kcriqui/2025-Communicator_Badge/README.md

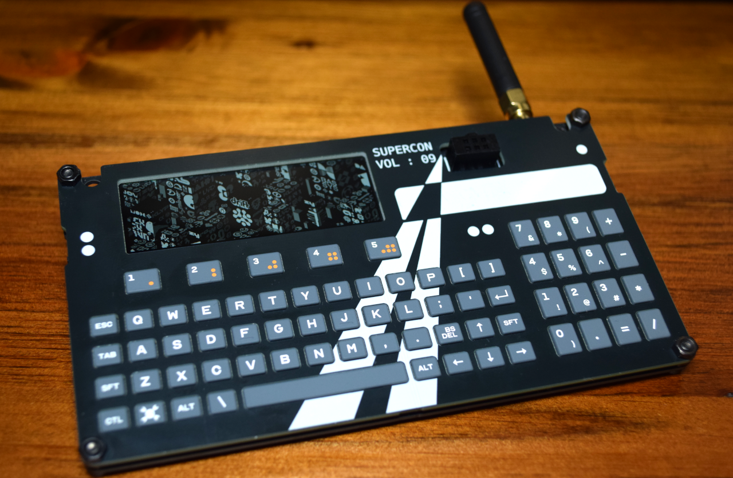
[picture p1: images/2025_badge_front_supercon_logo.png]
The_Badge 2025 Hackaday Supercon Communicator Badge
