kcriqui/2025-Communicator_Badge/documentation/datasheets/spi_screen_connector.png

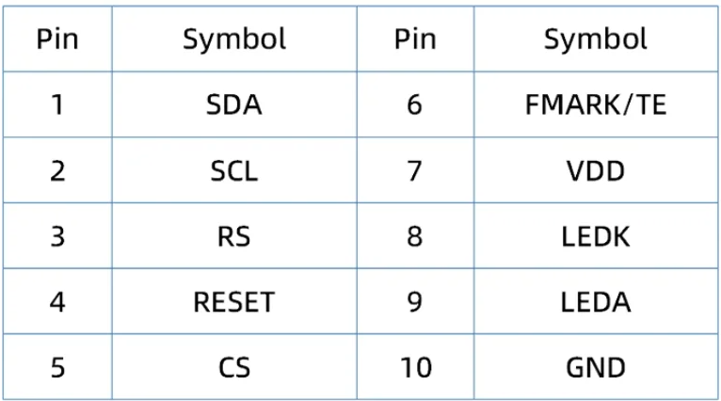
documentation/datasheets/spi_screen_connector.png
