kcriqui/2025-Communicator_Badge/documentation/datasheets/spi_screen_physical.png

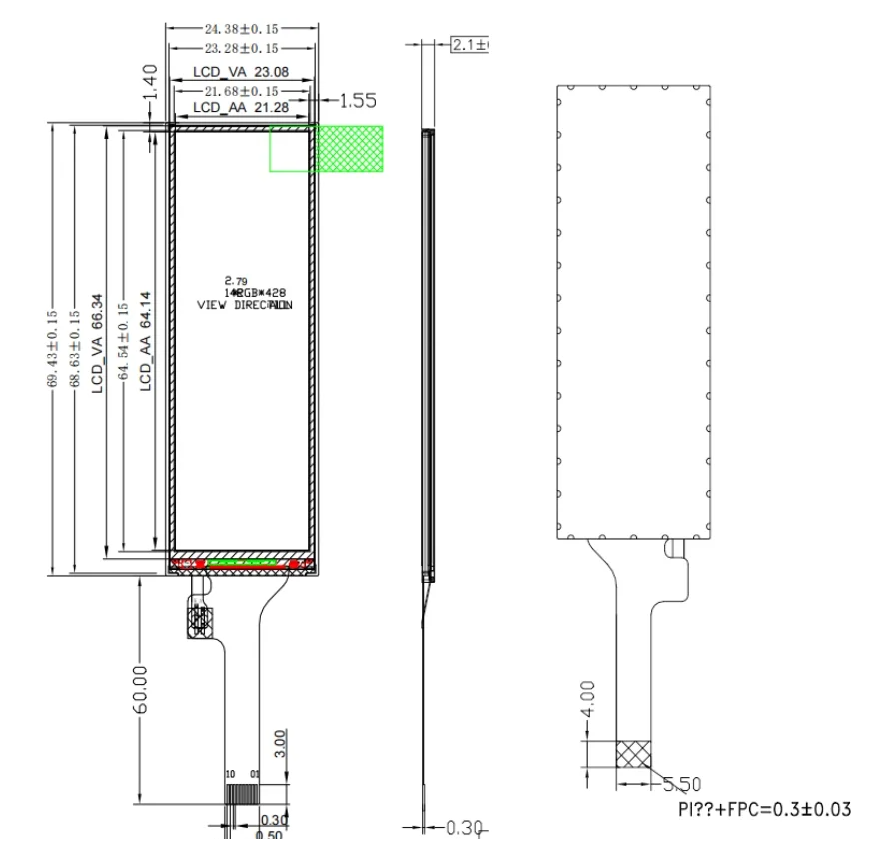
documentation/datasheets/spi_screen_physical.png
