kcriqui/2025-Communicator_Badge/hardware/communicator_proto_3d.png

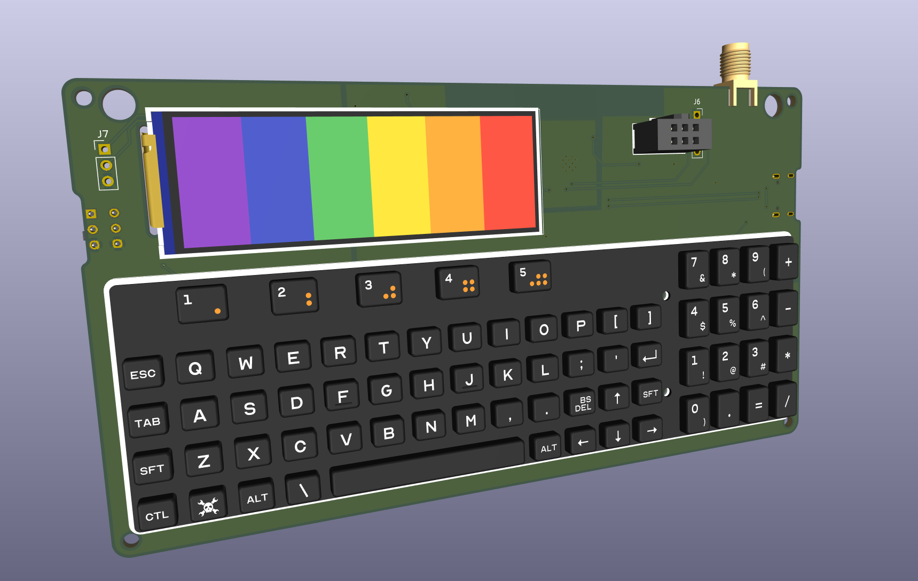
hardware/communicator_proto_3d.png
