kcriqui/2025-Communicator_Badge/hardware/communicator_proto_back_3d.png

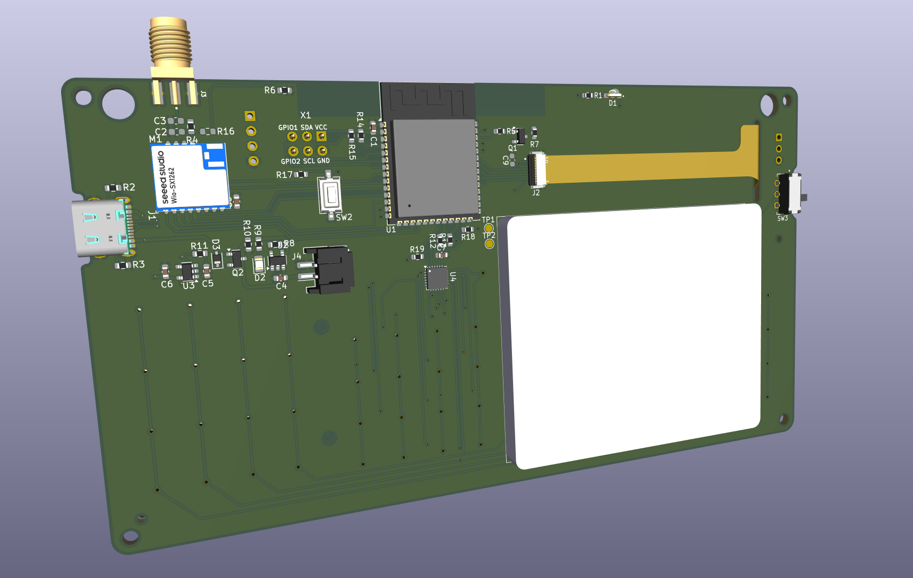
hardware/communicator_proto_back_3d.png
