kcriqui/2025-Communicator_Badge/images/2025_supercon_header.png

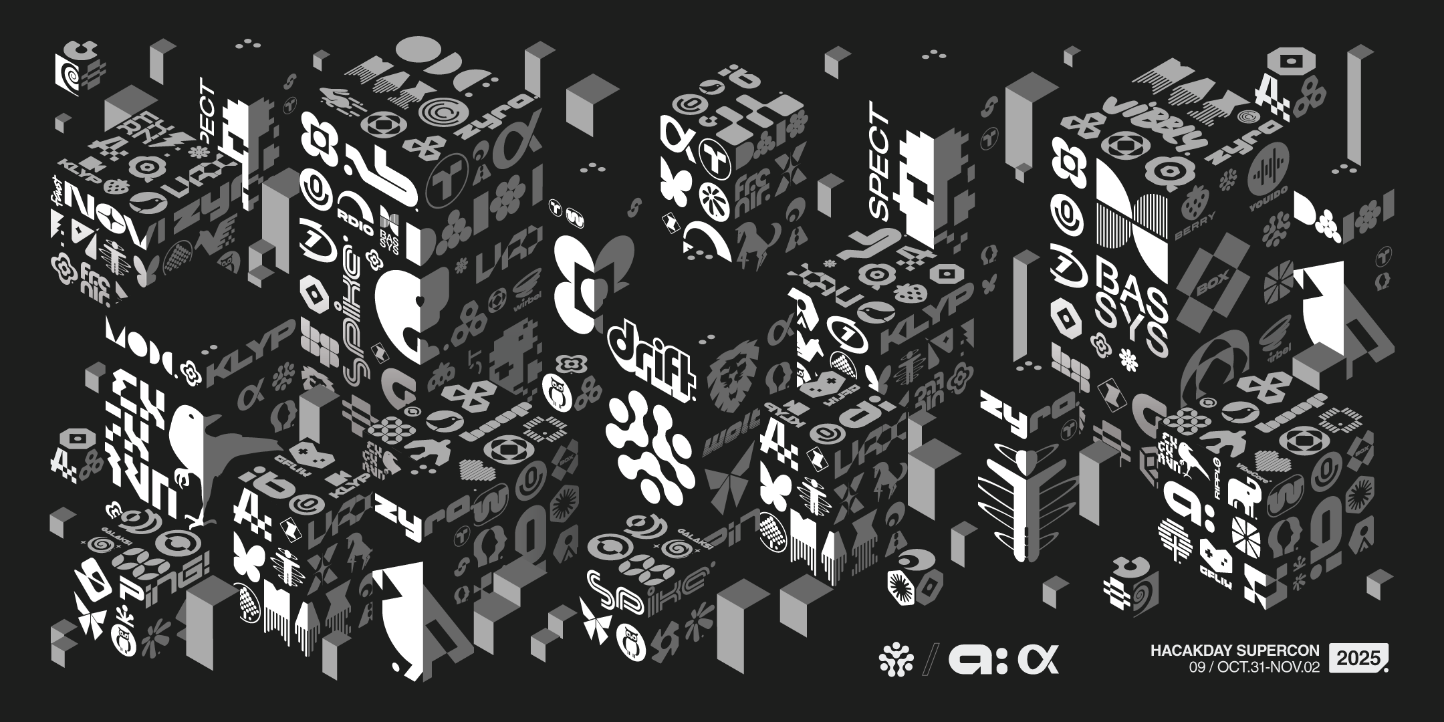
images/2025_supercon_header.png
