kcriqui/2025-Communicator_Badge/hardware/mechanicals_and_models/communicator_badge_main_pcb.FCStd

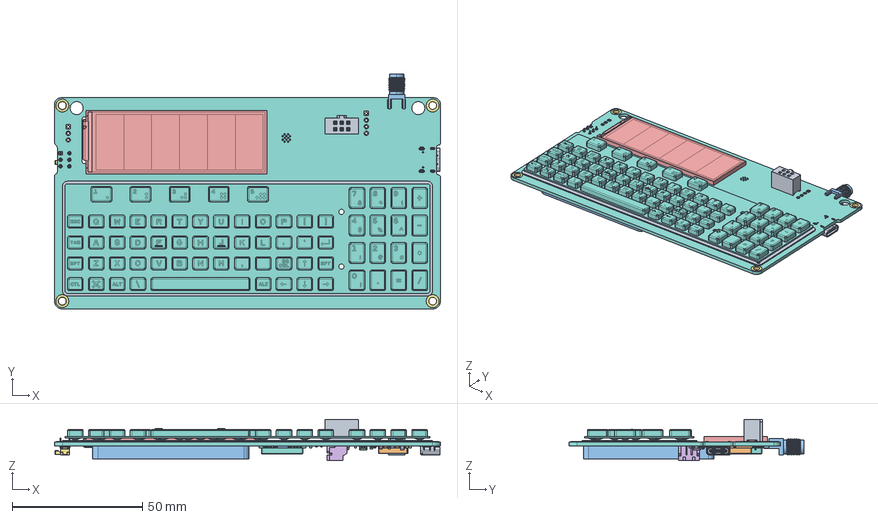
[picture p7: CAD file, 2025-10-24]
hardware/mechanicals_and_models/communicator_badge_main_pcb.FCStd
148.0 x 90.1 x 15.8 mm
SFH11-xC-Dx-ST-BK body_03
pin^SFH11-xC-Dx-ST-BK Ass
pin^SFH11-xC-Dx-ST-BK Ass001
pin^SFH11-xC-Dx-ST-BK Ass002
pin^SFH11-xC-Dx-ST-BK Ass003
pin^SFH11-xC-Dx-ST-BK Ass004
pin^SFH11-xC-Dx-ST-BK Ass005
Keyboard
Dome_Sheet
R_0603_1608Metric
LED_0805_2012Metric
R_0603_1608Metric001
R_0603_1608Metric002
R_0603_1608Metric003
SLW-91353-2A-RA-D
D_SOD-323
12402012E212A
R_0603_1608Metric004
R_0603_1608Metric005
SOT-23-5
R_0603_1608Metric006
C_0603_1608Metric
R_0603_1608Metric007
ESP32-S3-WROOM-1
C_0603_1608Metric001
Wio-SX1262_ v1
C_0603_1608Metric002
R_0603_1608Metric008
glass housing
PCB
contact-pins
R_0603_1608Metric009
C_0603_1608Metric003
C_0603_1608Metric004
TCA8418RTWR
SW_Tactile_SPST_NO_Straight_CK_PTS636Sx25SMTRLFS
SOT-23
SOT-23-006
R_0603_1608Metric010
R_0603_1608Metric011
R_0603_1608Metric012
R_0603_1608Metric013
CON-SMA-EDGE-S_CON-SMA-EDGE-S
c-1-2328702-0-a-3d
ER-TFT2.79-1
R_0603_1608Metric014
R_0603_1608Metric015
R_0603_1608Metric016
SOT-024
C_0603_1608Metric005
LiPo-Body
R_0603_1608Metric017
R_0603_1608Metric018
S2B-PH-SM4-TB
communicator_pcb_pad
communicator_pcb_PCB
