kcriqui/2025-Communicator_Badge/hardware/communicator_front/communicator_pcb-front_boardBody.dxf

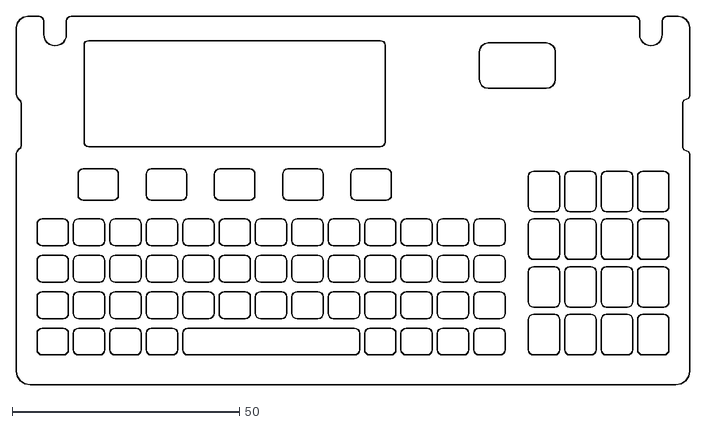
[picture p8: CAD file, 2025-10-23]
hardware/communicator_front/communicator_pcb-front_boardBody.dxf
148.0 x 81.0
