kcriqui/2025-Communicator_Badge/hardware/communicator_pcb.FCStd

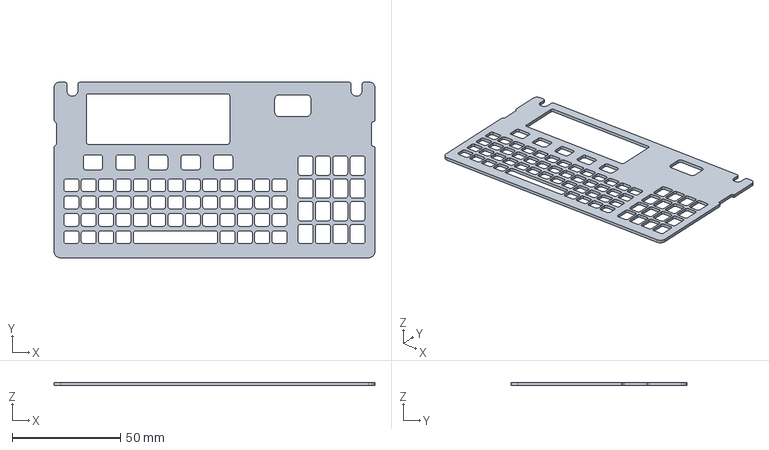
[picture p9: CAD file, 2025-10-23]
hardware/communicator_pcb.FCStd
148.0 x 81.0 x 1.60 mm
