kcriqui/2025-Communicator_Badge/hardware/communicator_pcb/CON_SMA_EDGE_S/CON-SMA-EDGE-S.step

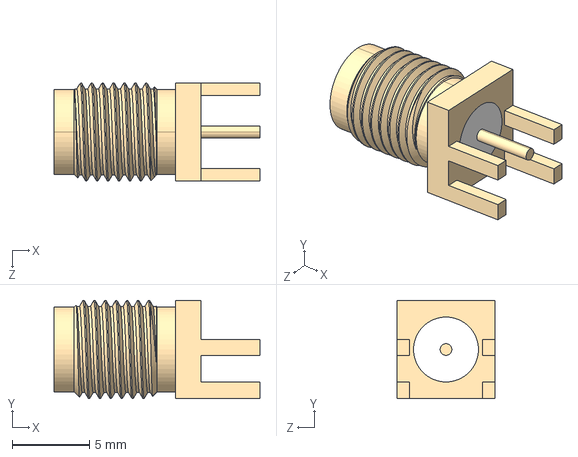
[picture p10: CAD file, 2025-10-23]
hardware/communicator_pcb/CON_SMA_EDGE_S/CON-SMA-EDGE-S.step
13.3 x 6.35 x 6.35 mm
