kcriqui/2025-Communicator_Badge/hardware/communicator_pcb/SAOv2/SFH11-PBPC-D03-ST-BK.STEP

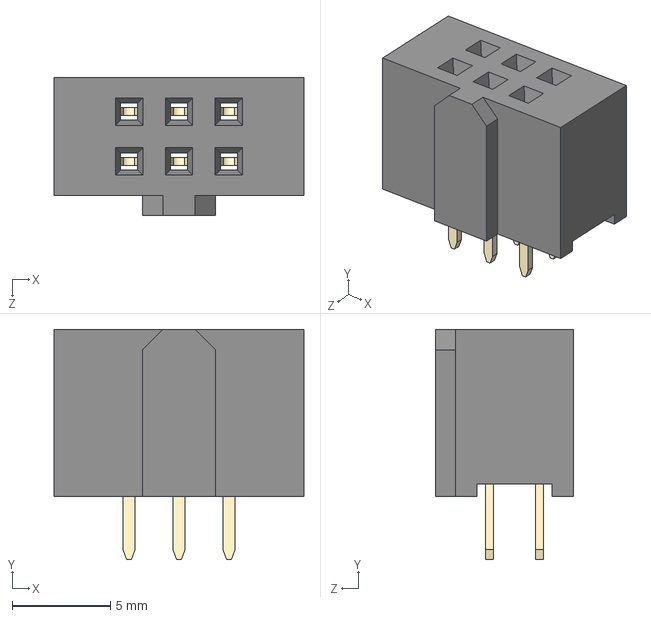
[picture p11: CAD file, 2025-10-23]
hardware/communicator_pcb/SAOv2/SFH11-PBPC-D03-ST-BK.STEP
12.7 x 11.7 x 7.01 mm
SFH11-xC-Dx-ST-BK body_03
pin^SFH11-xC-Dx-ST-BK Ass x 6
