kcriqui/2025-Communicator_Badge/hardware/communicator_pcb/SLW_1353_2A_RA_D/SLW-91353-2A-RA-D.step

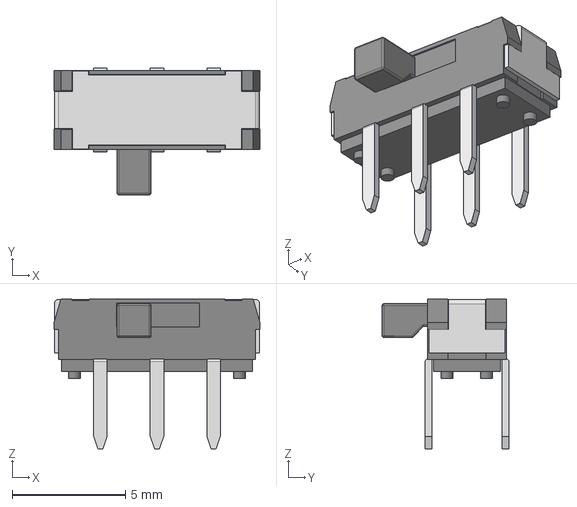
[picture p12: CAD file, 2025-10-23]
hardware/communicator_pcb/SLW_1353_2A_RA_D/SLW-91353-2A-RA-D.step
9.10 x 5.60 x 6.61 mm
