kcriqui/2025-Communicator_Badge/hardware/communicator_pcb/SMDNut/SMDNut_M2.0_H2.0mm.step

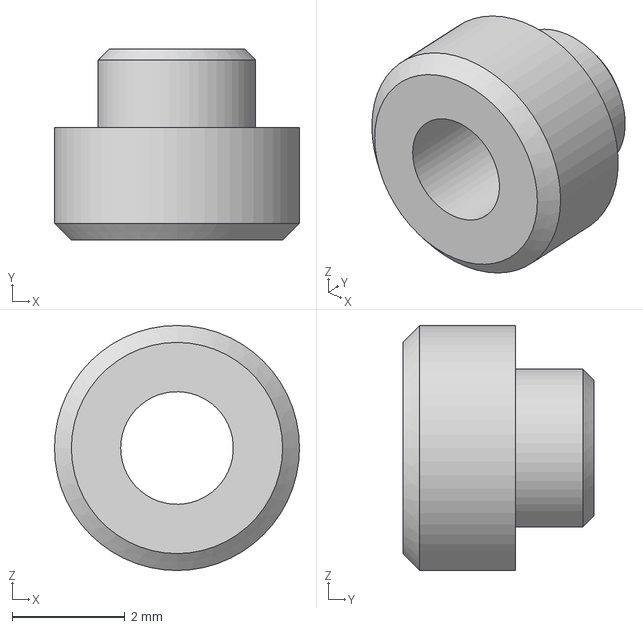
[picture p13: CAD file, 2025-10-23]
hardware/communicator_pcb/SMDNut/SMDNut_M2.0_H2.0mm.step
4.35 x 3.40 x 4.35 mm
