kcriqui/2025-Communicator_Badge/hardware/communicator_pcb/tca8418/QFN50P400X400X80-25N.step

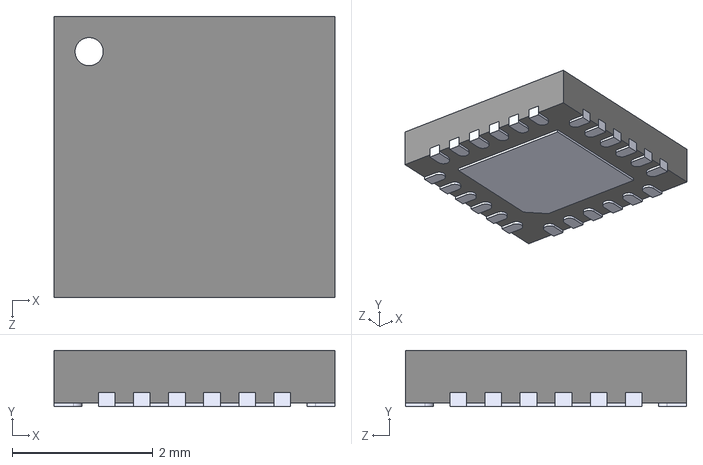
[picture p14: CAD file, 2025-10-23]
hardware/communicator_pcb/tca8418/QFN50P400X400X80-25N.step
4.00 x 0.8 x 4.00 mm
