kcriqui/2025-Communicator_Badge/hardware/communicator_pcb/TE_1-2328702-0/c-1-2328702-0-a-3d.step

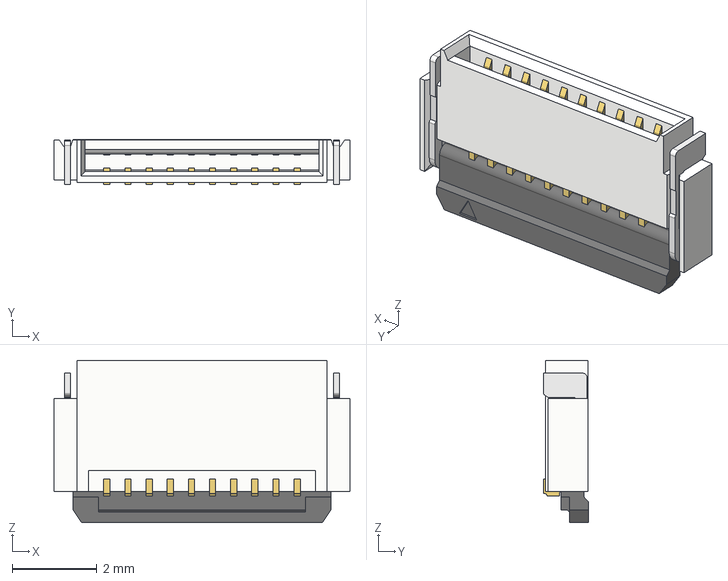
[picture p15: CAD file, 2025-10-23]
hardware/communicator_pcb/TE_1-2328702-0/c-1-2328702-0-a-3d.step
7.00 x 1.06 x 3.83 mm
