kcriqui/2025-Communicator_Badge/hardware/communicator_pcb/Wio1262/Wio-SX1262.step

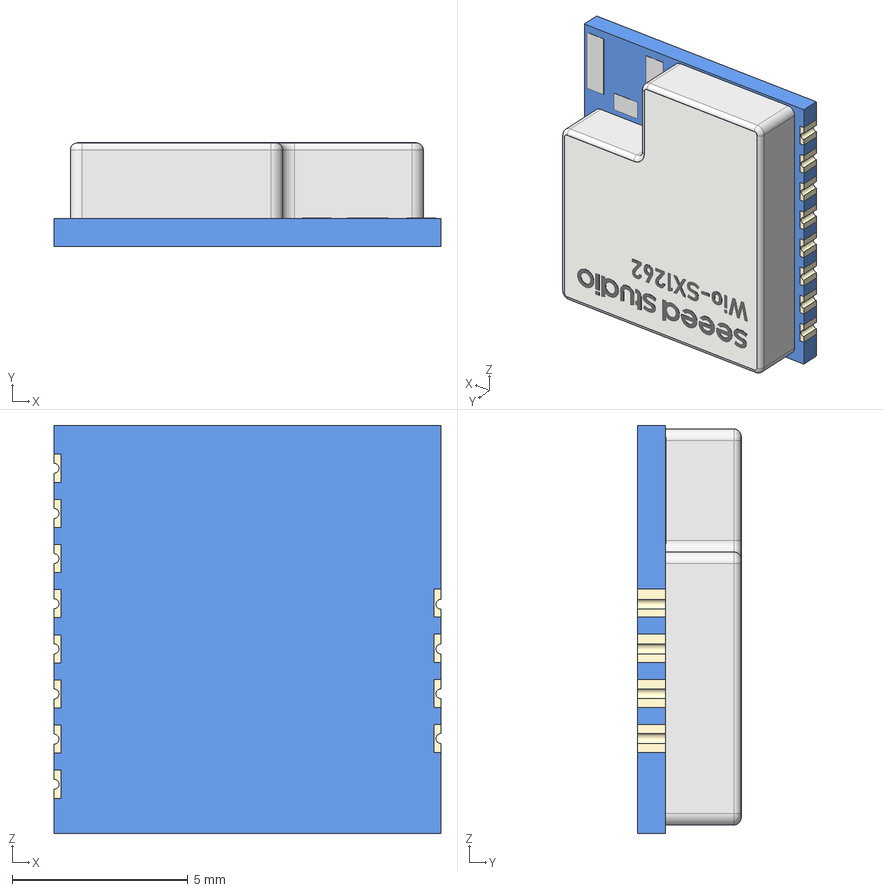
[picture p16: CAD file, 2025-10-23]
hardware/communicator_pcb/Wio1262/Wio-SX1262.step
11.0 x 2.97 x 11.6 mm
