kcriqui/2025-Communicator_Badge/hardware/communicator_pcb/wurth_led_155124YS73200/Common-Parts-Library.step

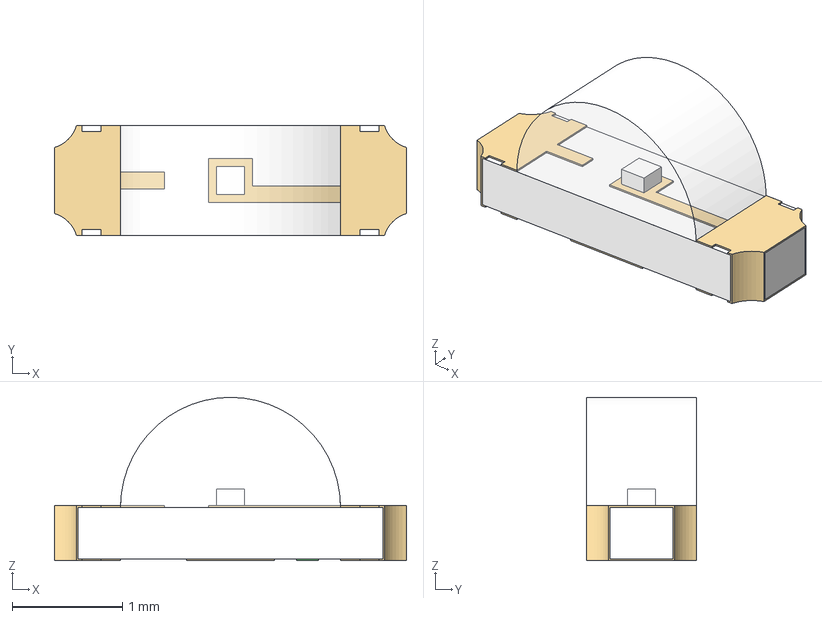
[picture p17: CAD file, 2025-10-23]
hardware/communicator_pcb/wurth_led_155124YS73200/Common-Parts-Library.step
3.20 x 1.00 x 1.48 mm
glass housing
PCB
contact-pins
