kcriqui/2025-Communicator_Badge/hardware/mechanicals_and_models/communicator_badge_front_pcb.step

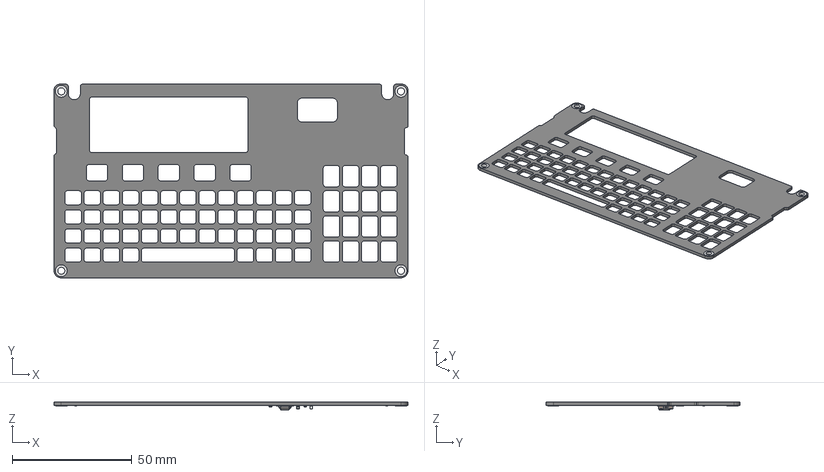
[picture p18: CAD file, 2025-10-24]
hardware/mechanicals_and_models/communicator_badge_front_pcb.step
148.0 x 81.0 x 3.39 mm
C_0805_2012Metric x 2
LED_0805_2012Metric
R_0805_2012Metric x 2
SOIC-8_3.9x4.9mm_P1.27mm
front_pcb_pad
front_pcb_PCB
