kcriqui/2025-Communicator_Badge/hardware/mechanicals_and_models/communicator_mechanical_components.step

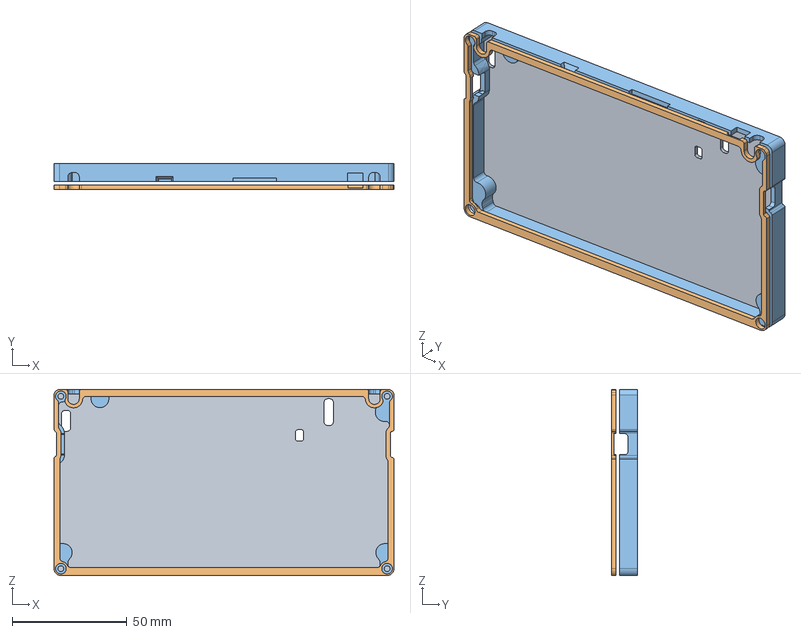
[picture p19: CAD file, 2025-10-24]
hardware/mechanicals_and_models/communicator_mechanical_components.step
148.0 x 11.5 x 81.0 mm
Back_cover
Front_Frame
Back_frame
