kcriqui/2025-Communicator_Badge/hardware/communicator_pcb/amphenol_12402012E212A/12402012E212A.step

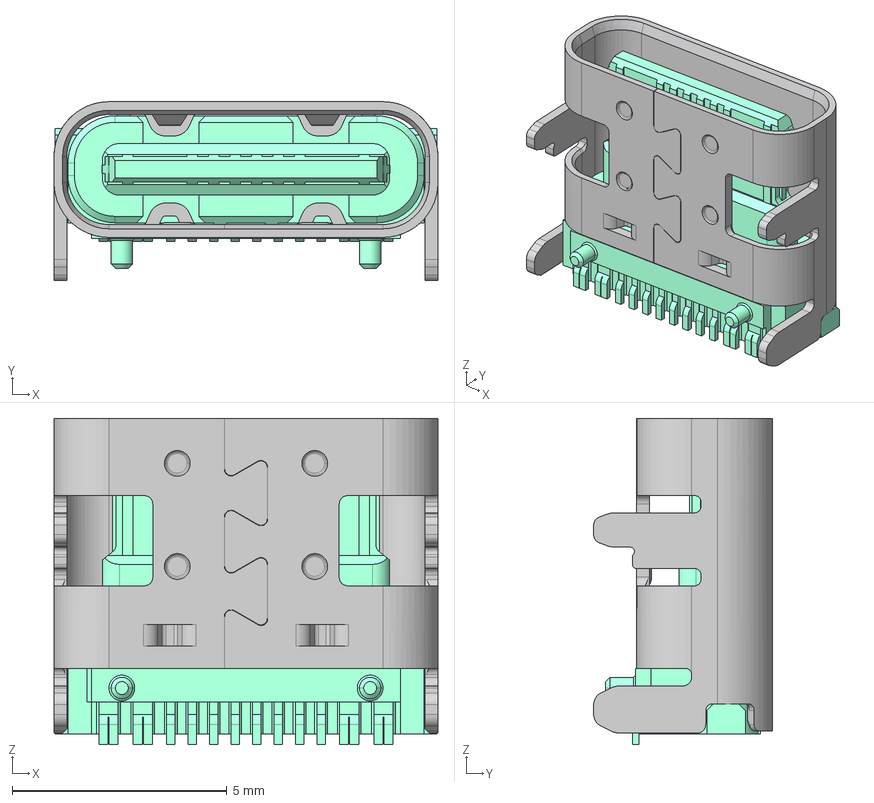
[picture p20: CAD file, 2025-10-23]
hardware/communicator_pcb/amphenol_12402012E212A/12402012E212A.step
8.94 x 4.16 x 7.60 mm
