kcriqui/2025-Communicator_Badge/(list of files, cad)

Other CAD files:
hardware/mechanicals_and_models/communicator_badge_front_pcb.FCStd
hardware/mechanicals_and_models/communicator_badge_front_pcb.dxf
hardware/mechanicals_and_models/communicator_mechanical_components.FCStd
