kcriqui/2025-Communicator_Badge/hardware/communicator_pcb/communicator_pcb.pdf

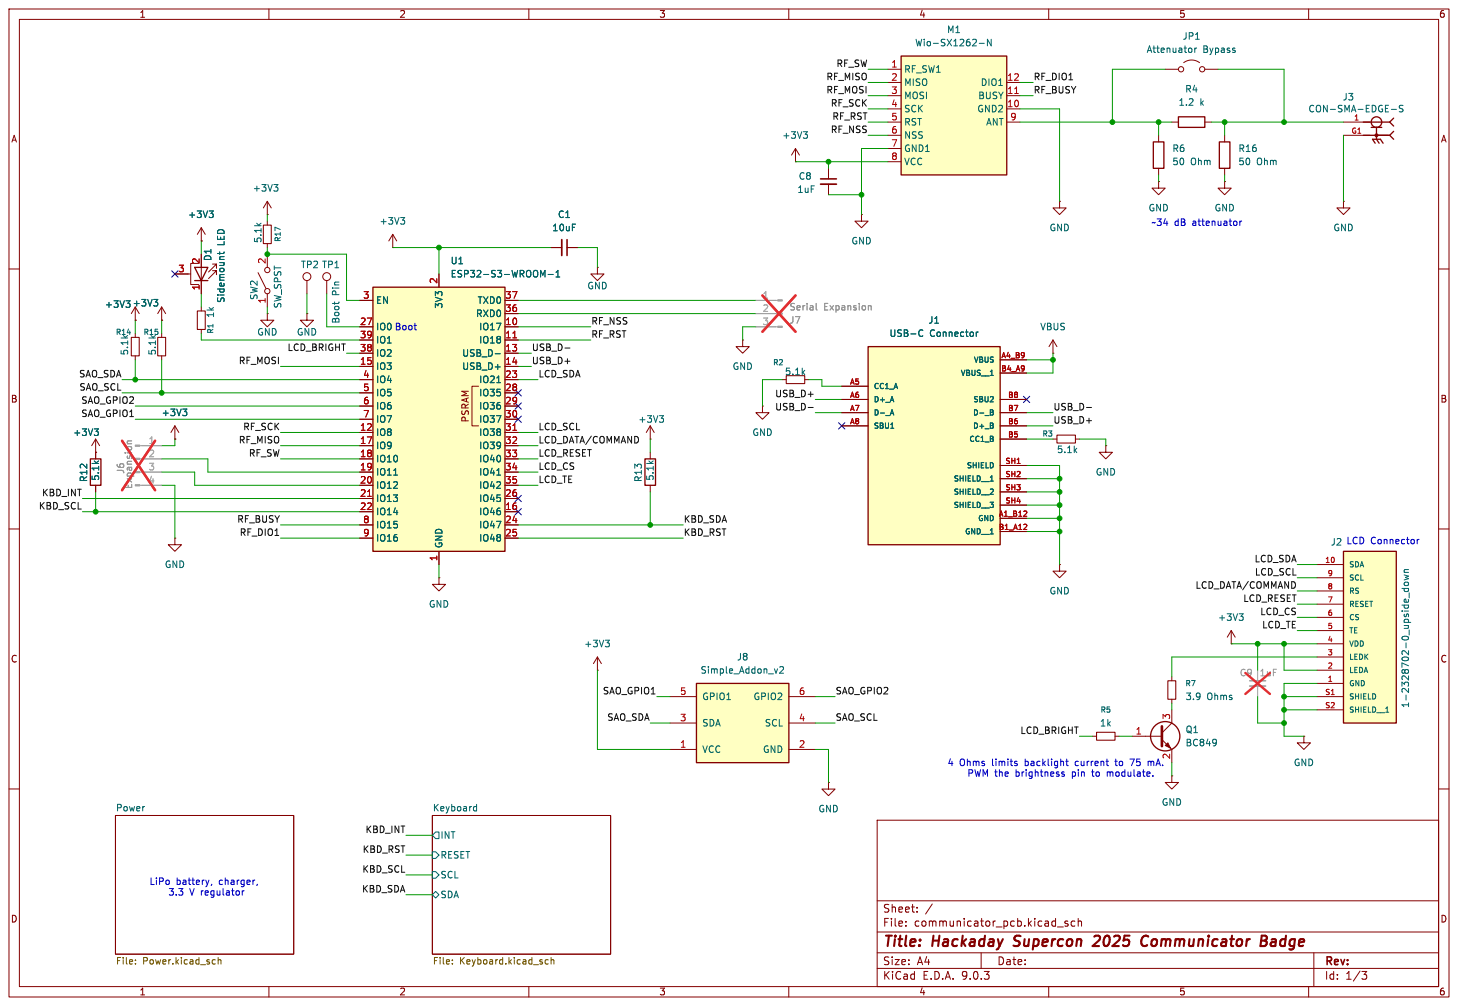
[picture p21: page 1]

INT RESET Keyboard File: Keyboard.kicad_sch

Id: 1/3 Title: Hackaday Supercon 2025 Communicator Badge

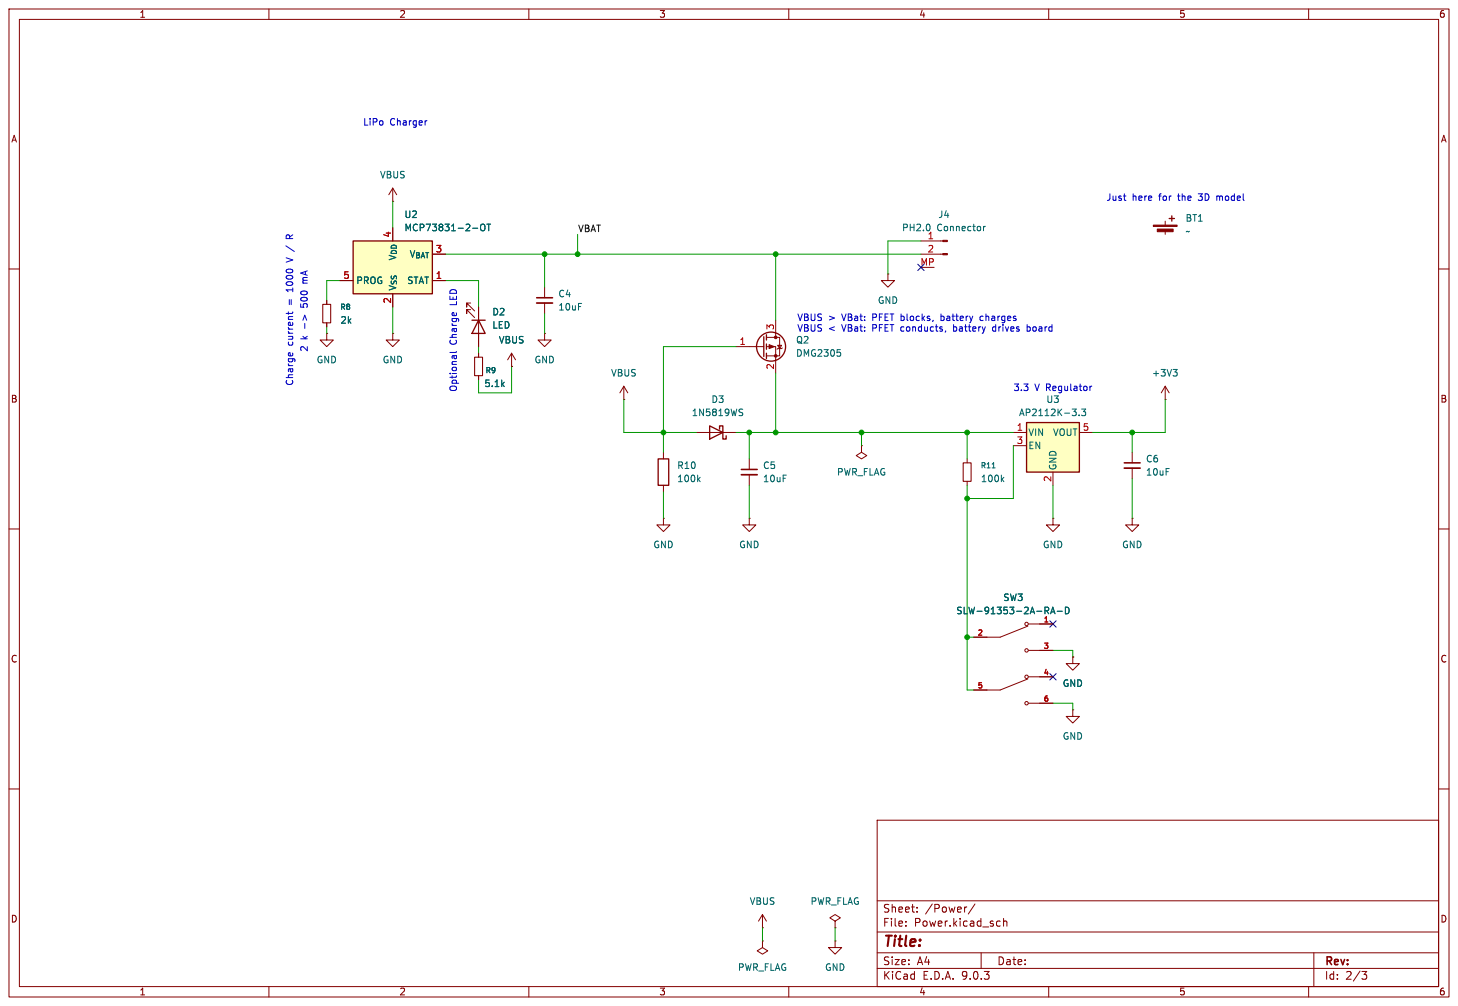
[picture p22: page 2]

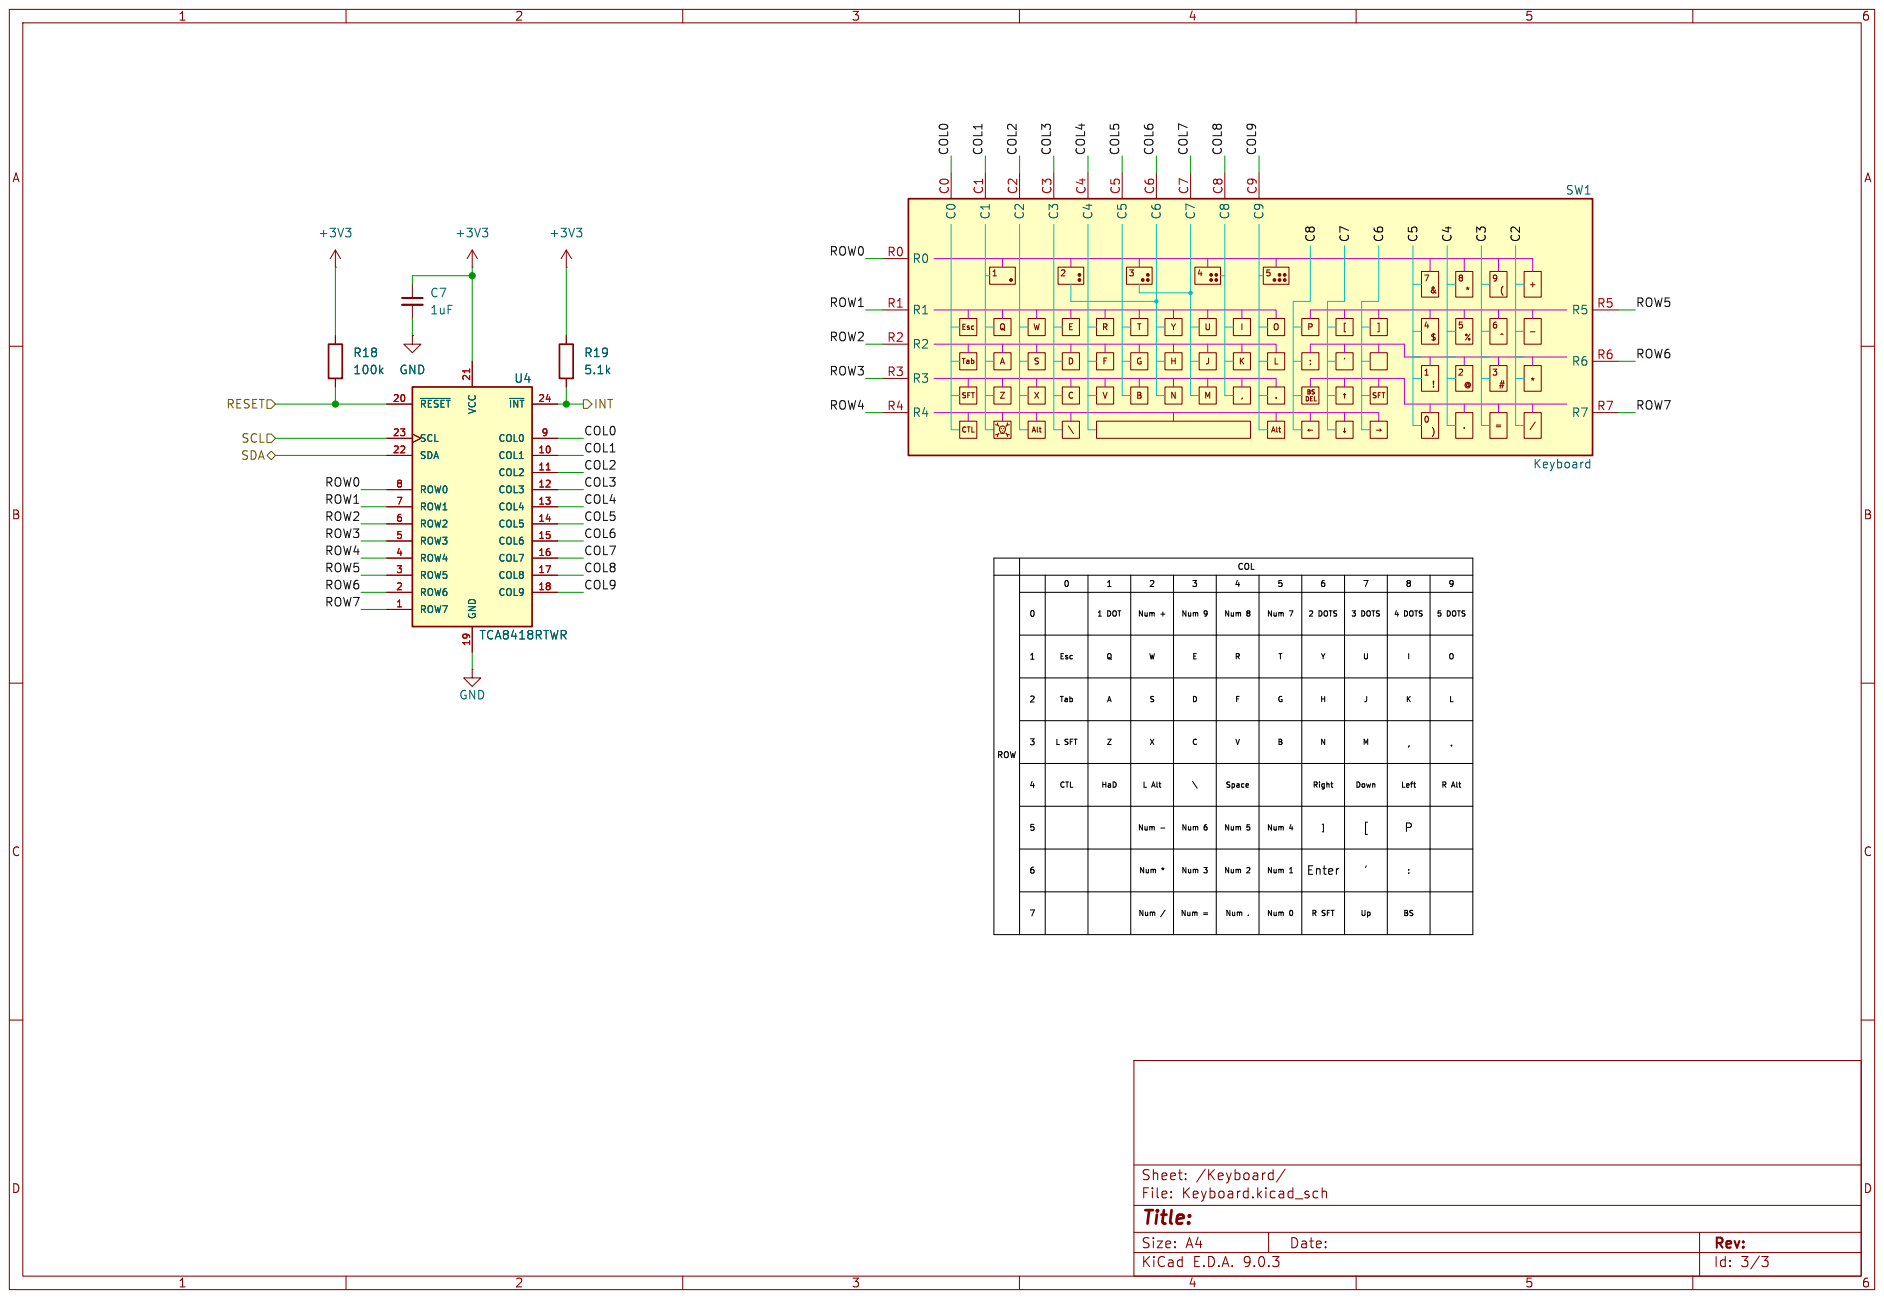
[picture p23: page 3]

0 | | 1 DOT | Num + | Num 9 | COL ROW Num 8 | Num 7 | 2 DOTS | 3 DOTS | 4 DOTS | 5 DOTS

1 | Esc | Q | W | E | R | T | Y | U | I | O

Id: 3/3 Title: File: Keyboard.kicad_sch Sheet: /Keyboard/
