kcriqui/2025-Communicator_Badge/hardware/communicator_front/front_pcb.kicad_pcb

## KiCad design hardware/communicator_front/front_pcb.kicad_pcb (2025-10-23)

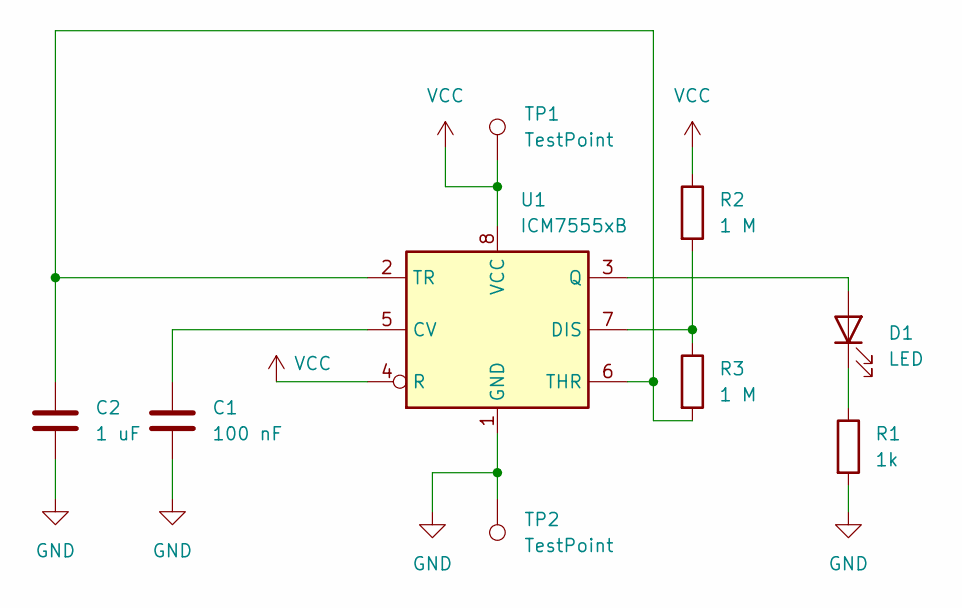
[picture p24: schematic front_pcb.kicad_sch, Bogus Schematic and Easter Egg for Fab]

Parts:
C1: 100 nF; C_0805_2012Metric_Pad1.18x1.45mm_HandSolder
C2: 1 uF; C_0805_2012Metric_Pad1.18x1.45mm_HandSolder
D1: LED; LED_0805_2012Metric_Pad1.15x1.40mm_HandSolder
R1: 1k; R_0805_2012Metric_Pad1.20x1.40mm_HandSolder
R2, R3: 1 M; R_0805_2012Metric_Pad1.20x1.40mm_HandSolder
TP1, TP2: TestPoint; TestPoint_Pad_2.5x2.5mm
U1: ICM7555xB; SOIC-8_3.9x4.9mm_P1.27mm

Connections:
GND: C1.2, C2.2, R1.2, TP2.1, U1.1 (GND)
unnamed: D1.2 (A), U1.3 (Q)
unnamed: D1.1 (K), R1.1
unnamed: C1.1, U1.5 (CV)
unnamed: R2.2, R3.1, U1.7 (DIS)
unnamed: C2.1, R3.2, U1.2 (TR), U1.6 (THR)
VCC: R2.1, TP1.1, U1.4 (R), U1.8 (VCC)

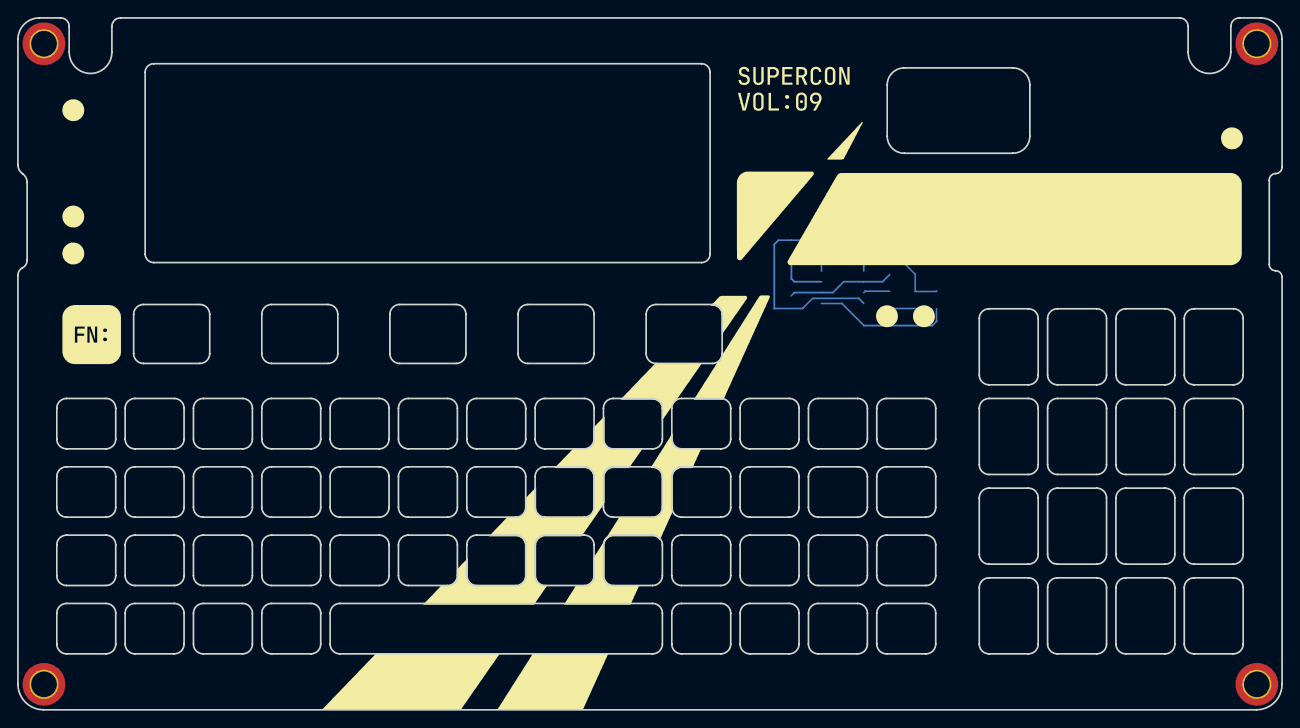
[picture p25: board front_pcb.kicad_pcb from above]

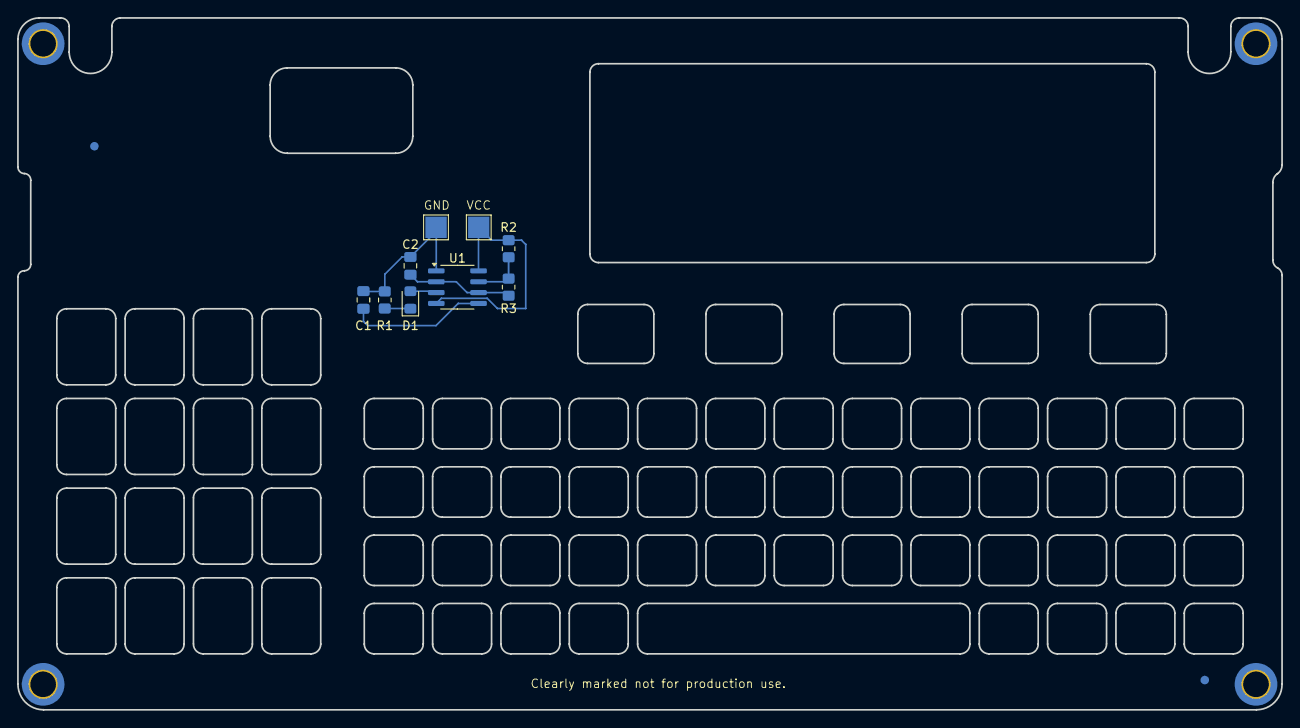
[picture p26: board front_pcb.kicad_pcb from below]

Board: 2 copper layers, 148.0 x 81.0 mm, 9 parts (9 on the bottom side), 7 nets.
