kcriqui/2025-Communicator_Badge/hardware/communicator_pcb/communicator_pcb.kicad_pcb

## KiCad design hardware/communicator_pcb/communicator_pcb.kicad_pcb (2025-10-23)

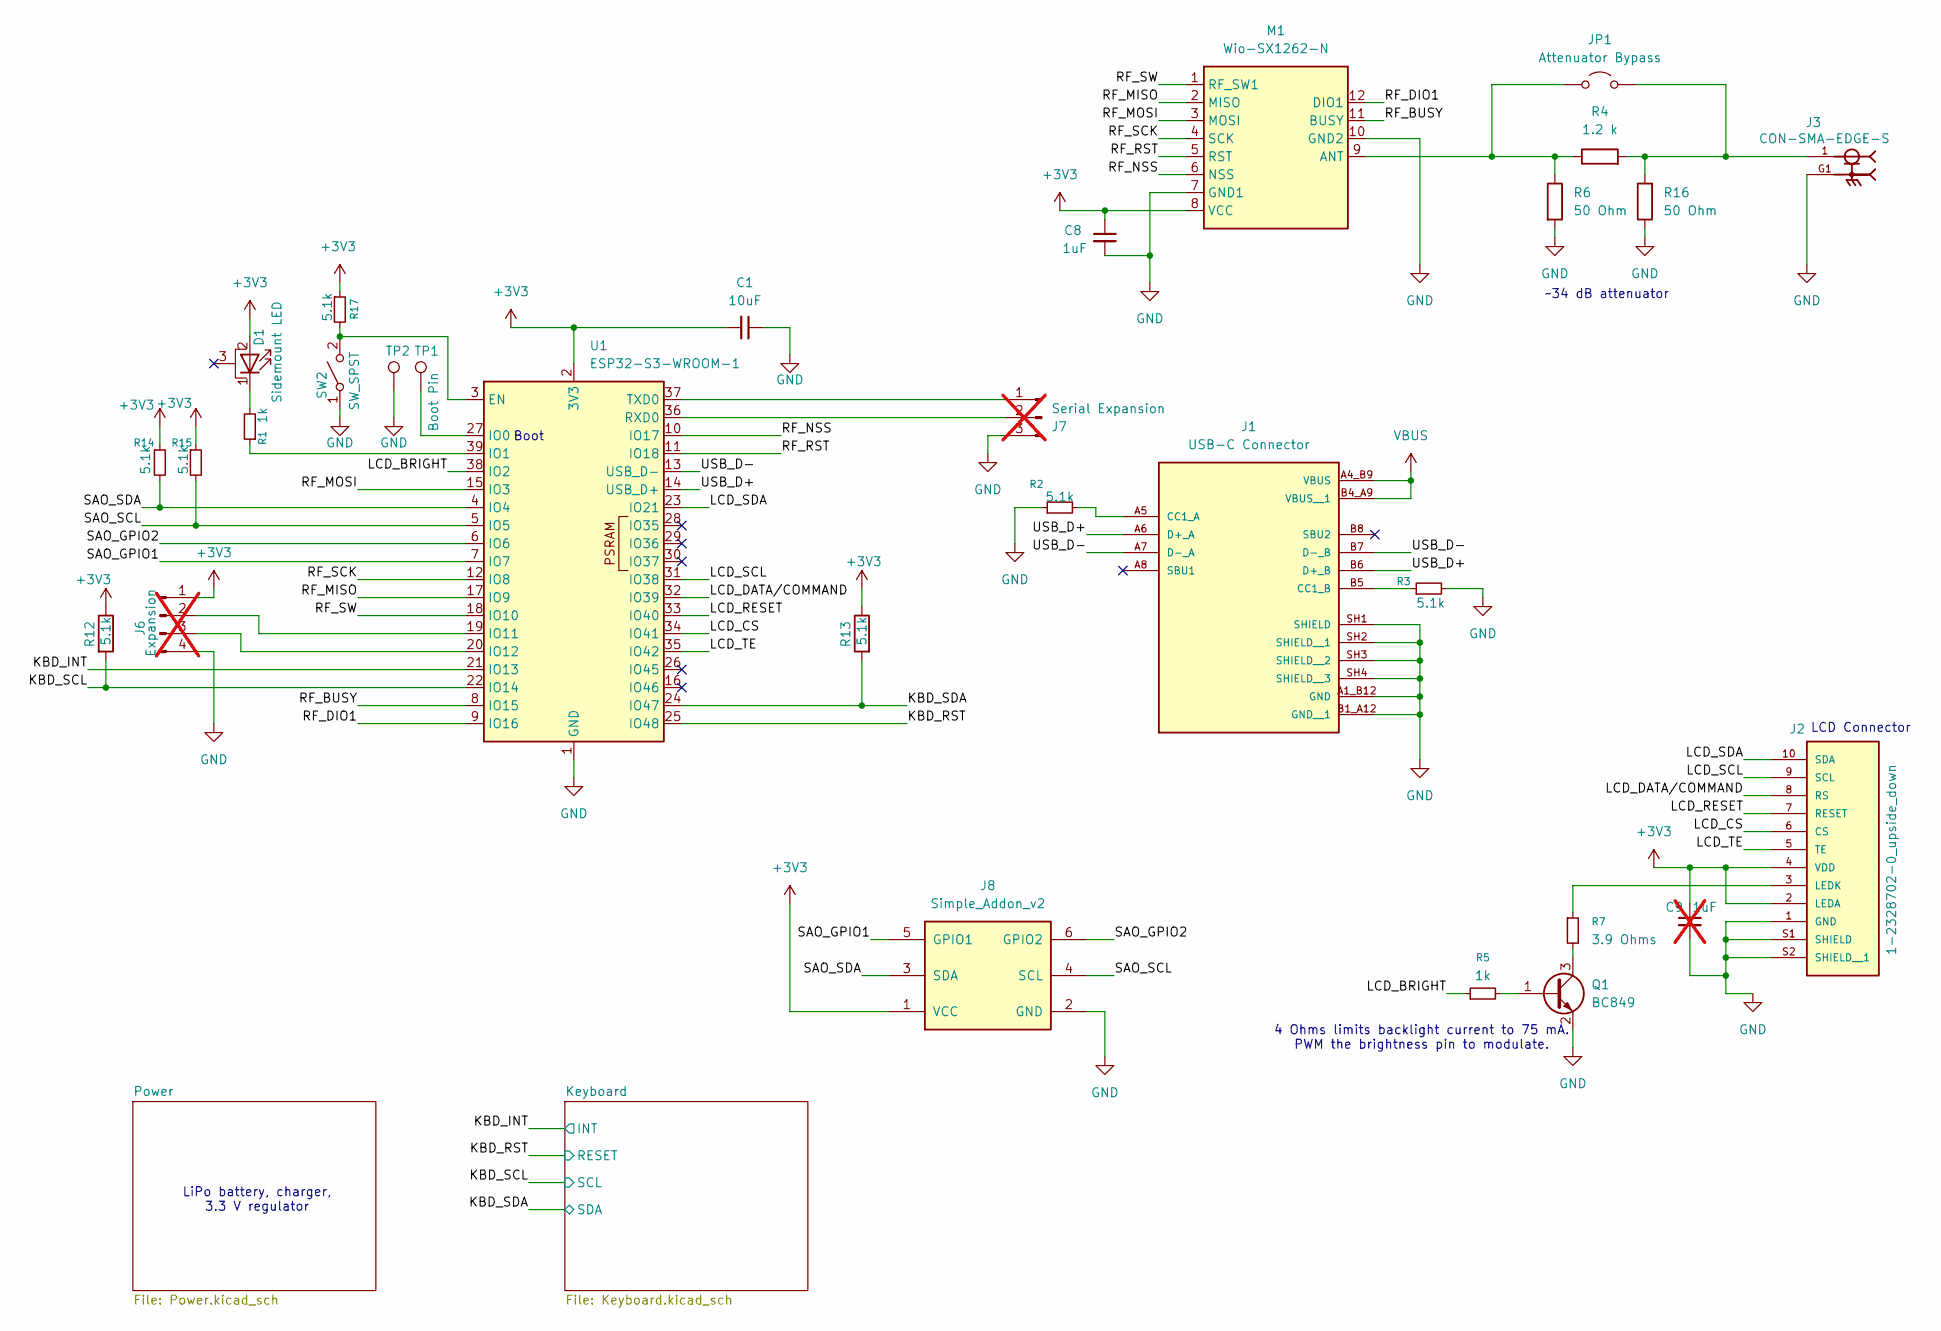
[picture p27: schematic communicator_pcb.kicad_sch, Hackaday Supercon 2025 Communicator Badge]

Parts:
C1: 10uF; C_0603_1608Metric
C8: 1uF; C_0603_1608Metric
C9: 1uF; C_0603_1608Metric; not fitted
D1: Sidemount LED; WL-SMSW_1204
J1: USB-C Connector; AMPHENOL_12402012E212A; PARTREV 4
J2: 1-2328702-0_upside_down; TE_1-2328702-0; PARTREV 5
J3: CON-SMA-EDGE-S; RFSOLUTIONS_CON-SMA-EDGE-S; PARTREV 1
J6: Expansion; PinSocket_1x04_P2.54mm_Vertical; not fitted
J7: Serial Expansion; PinHeader_1x03_P2.54mm_Vertical; not fitted
J8: Simple_Addon_v2; Simple_Addon_v2-BADGE-2x3
JP1: Attenuator Bypass; SolderJumper-2_P1.3mm_Open_RoundedPad1.0x1.5mm
M1: Wio-SX1262-N; Wio1262-N
Q1: BC849; SOT-23
R1, R5: 1k; R_0603_1608Metric
R2, R3, R12, R13, R14, R15, R17: 5.1k; R_0603_1608Metric
R4: 1.2 k; R_0603_1608Metric_Pad0.98x0.95mm_HandSolder
R6, R16: 50 Ohm; R_0603_1608Metric_Pad0.98x0.95mm_HandSolder
R7: 3.9 Ohms; R_0603_1608Metric
SW2: SW_SPST; SW_Tactile_SPST_NO_Straight_CK_PTS636Sx25SMTRLFS
TP1: Boot Pin; TestPoint_Pad_D1.5mm
TP2: TestPoint; TestPoint_Pad_D1.5mm
U1: ESP32-S3-WROOM-1

Connections:
+3V3: C1.2, C8.1, C9.1, D1.2 (A), J2.2 (LEDA), J2.4 (VDD), J6.1, J8.1 (VCC), M1.8 (VCC), R12.1, R13.1, R14.1, R15.1, R17.1, U1.2 (3V3); also elsewhere on the board
/KBD_INT: U1.21 (IO13); also elsewhere on the board
/KBD_RST: U1.25 (IO48); also elsewhere on the board
/KBD_SCL: R12.2, U1.22 (IO14); also elsewhere on the board
/KBD_SDA: R13.2, U1.24 (IO47); also elsewhere on the board
/LCD_BRIGHT: R5.1, U1.38 (IO2)
/LCD_CS: J2.6 (CS), U1.34 (IO41)
/LCD_DATA/COMMAND: J2.8 (RS), U1.32 (IO39)
/LCD_RESET: J2.7 (RESET), U1.33 (IO40)
/LCD_SCL: J2.9 (SCL), U1.31 (IO38)
/LCD_SDA: J2.10 (SDA), U1.23 (IO21)
/LCD_TE: J2.5 (TE), U1.35 (IO42)
/RF_BUSY: M1.11 (BUSY), U1.8 (IO15)
/RF_DIO1: M1.12 (DIO1), U1.9 (IO16)
/RF_MISO: M1.2 (MISO), U1.17 (IO9)
/RF_MOSI: M1.3 (MOSI), U1.15 (IO3)
/RF_NSS: M1.6 (NSS), U1.10 (IO17)
/RF_RST: M1.5 (RST), U1.11 (IO18)
/RF_SCK: M1.4 (SCK), U1.12 (IO8)
/RF_SW: M1.1 (RF_SW1), U1.18 (IO10)
/SAO_GPIO1: J8.5 (GPIO1), U1.7 (IO7)
/SAO_GPIO2: J8.6 (GPIO2), U1.6 (IO6)
/SAO_SCL: J8.4 (SCL), R15.2, U1.5 (IO5)
/SAO_SDA: J8.3 (SDA), R14.2, U1.4 (IO4)
/USB_D+: J1.A6 (D+_A), J1.B6 (D+_B), U1.14 (USB_D+)
/USB_D-: J1.A7 (D-_A), J1.B7 (D-_B), U1.13 (USB_D-)
GND: C1.1, C8.2, C9.2, J1.A1_B12 (GND), J1.B1_A12 (GND__1), J1.SH1 (SHIELD), J1.SH2 (SHIELD__1), J1.SH3 (SHIELD__2), J1.SH4 (SHIELD__3), J2.1 (GND), J2.S1 (SHIELD), J2.S2 (SHIELD__1), J3.G1, J3.G2, J3.G3, J3.G4, J6.4, J7.3, J8.2 (GND), M1.7 (GND1), M1.10 (GND2), Q1.2 (E), R2.1, R3.2, R6.2, R16.1, SW2.1 (A), TP2.1, U1.1 (GND), U1.40 (GND), U1.41 (GND); also elsewhere on the board
unnamed: D1.1 (K), R1.2
unnamed: J1.A5 (CC1_A), R2.2
unnamed: J1.B5 (CC1_B), R3.1
unnamed: J2.3 (LEDK), R7.1
unnamed: J6.2, U1.19 (IO11)
unnamed: J6.3, U1.20 (IO12)
unnamed: J7.1, U1.37 (TXD0)
unnamed: J7.2, U1.36 (RXD0)
unnamed: JP1.1 (A), M1.9 (ANT), R4.1, R6.1
unnamed: J3.1, JP1.2 (B), R4.2, R16.2
unnamed: Q1.1 (B), R5.2
unnamed: Q1.3 (C), R7.2
unnamed: R17.2, SW2.2 (B), U1.3 (EN)
unnamed: TP1.1, U1.27 (IO0)
unnamed: R1.1, U1.39 (IO1)
VBUS: J1.A4_B9 (VBUS), J1.B4_A9 (VBUS__1); also elsewhere on the board

Notes on the sheet:
~34 dB attenuator
LCD Connector
LiPo battery, charger, 3.3 V regulator
Boot
4 Ohms limits backlight current to 75 mA. PWM the brightness pin to modulate.

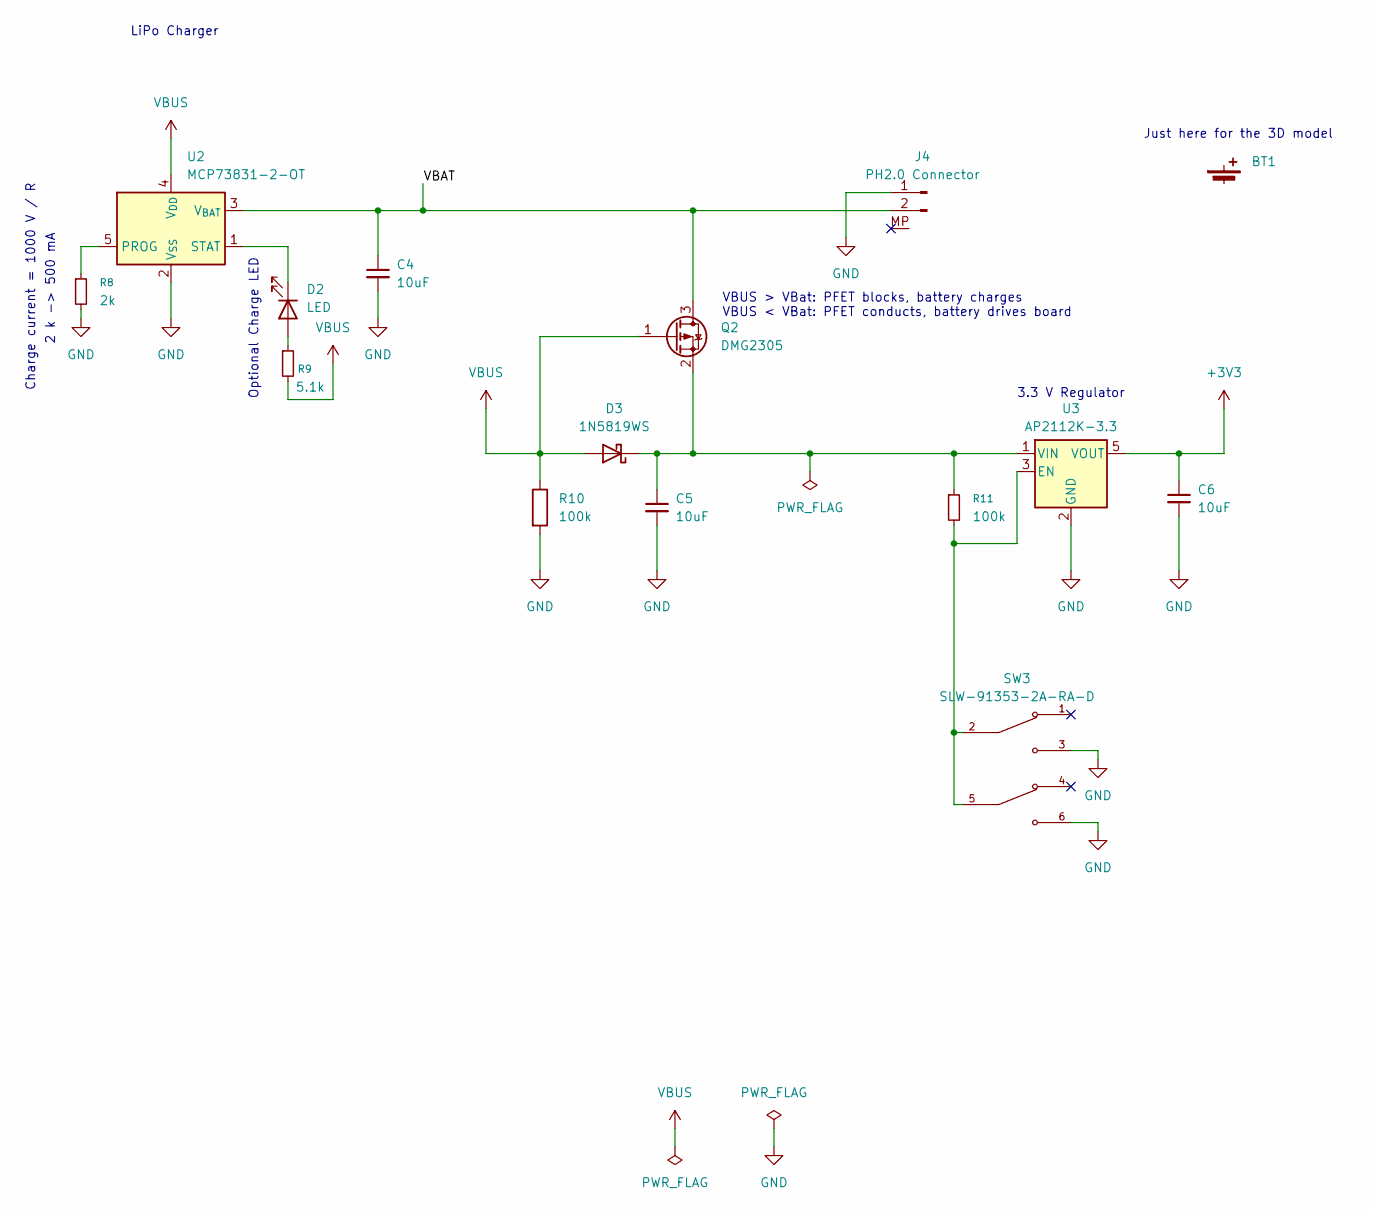
[picture p28: schematic Power.kicad_sch]

Parts:
BT1: BatteryMockup
C4, C5, C6: 10uF; C_0603_1608Metric
D2: LED; LED_0805_2012Metric
D3: 1N5819WS; D_SOD-323
J4: PH2.0 Connector; JST_PH_S2B-PH-SM4-TB_1x02-1MP_P2.00mm_Horizontal
Q2: DMG2305; SOT-23
R8: 2k; R_0603_1608Metric
R9: 5.1k; R_0603_1608Metric
R10, R11: 100k; R_0603_1608Metric
SW3: SLW-91353-2A-RA-D; SW_SLW-91353-2A-RA-D; PARTREV 1.01
U2: MCP73831-2-OT; SOT-23-5
U3: AP2112K-3.3; SOT-23-5

Connections:
+3V3: C6.1, U3.5 (VOUT); also elsewhere on the board
/Power/VBAT: C4.1, J4.2, Q2.3 (D), U2.3 (V_{BAT})
GND: C4.2, C5.2, C6.2, J4.1, R8.2, R10.2, SW3.3, SW3.6, U2.2 (V_{SS}), U3.2 (GND); also elsewhere on the board
unnamed: D2.2 (A), R9.1
unnamed: D2.1 (K), U2.1 (STAT)
unnamed: C5.1, D3.1 (K), Q2.2 (S), R11.1, U3.1 (VIN)
unnamed: R8.1, U2.5 (PROG)
unnamed: R11.2, SW3.2, SW3.5, U3.3 (EN)
VBUS: D3.2 (A), Q2.1 (G), R9.2, R10.1, U2.4 (V_{DD}); also elsewhere on the board

Notes on the sheet:
Optional Charge LED
Just here for the 3D model
VBUS > VBat: PFET blocks, battery charges VBUS < VBat: PFET conducts, battery drives board
Charge current = 1000 V / R
2 k -> 500 mA
LiPo Charger
3.3 V Regulator

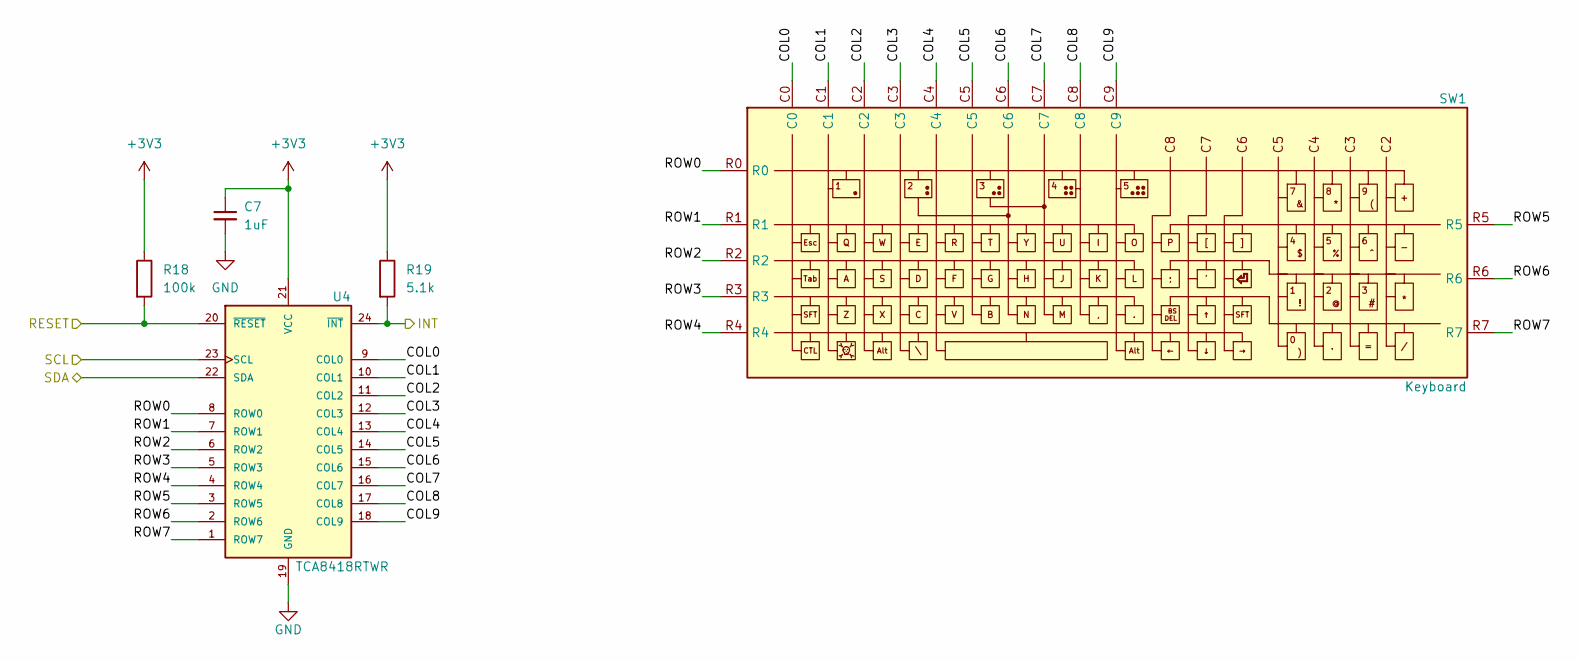
[picture p29: schematic Keyboard.kicad_sch]

Parts:
C7: 1uF; C_0603_1608Metric
R18: 100k; R_0603_1608Metric
R19: 5.1k; R_0603_1608Metric
SW1: Keyboard
U4: TCA8418RTWR; VQFN-24-1EP_4x4mm_P0.5mm_EP2.5x2.5mm; PARTREV G

Connections:
+3V3: C7.1, R18.1, R19.1, U4.21 (VCC); also elsewhere on the board
/KBD_INT: R19.2, U4.24 (~INT); also elsewhere on the board
/KBD_RST: R18.2, U4.20 (~RESET); also elsewhere on the board
/KBD_SCL: U4.23 (SCL); also elsewhere on the board
/KBD_SDA: U4.22 (SDA); also elsewhere on the board
/Keyboard/COL0: SW1.C0, U4.9 (COL0)
/Keyboard/COL1: SW1.C1, U4.10 (COL1)
/Keyboard/COL2: SW1.C2, U4.11 (COL2)
/Keyboard/COL3: SW1.C3, U4.12 (COL3)
/Keyboard/COL4: SW1.C4, U4.13 (COL4)
/Keyboard/COL5: SW1.C5, U4.14 (COL5)
/Keyboard/COL6: SW1.C6, U4.15 (COL6)
/Keyboard/COL7: SW1.C7, U4.16 (COL7)
/Keyboard/COL8: SW1.C8, U4.17 (COL8)
/Keyboard/COL9: SW1.C9, U4.18 (COL9)
/Keyboard/ROW0: SW1.R0, U4.8 (ROW0)
/Keyboard/ROW1: SW1.R1, U4.7 (ROW1)
/Keyboard/ROW2: SW1.R2, U4.6 (ROW2)
/Keyboard/ROW3: SW1.R3, U4.5 (ROW3)
/Keyboard/ROW4: SW1.R4, U4.4 (ROW4)
/Keyboard/ROW5: SW1.R5, U4.3 (ROW5)
/Keyboard/ROW6: SW1.R6, U4.2 (ROW6)
/Keyboard/ROW7: SW1.R7, U4.1 (ROW7)
GND: C7.2, U4.19 (GND), U4.25 (EP); also elsewhere on the board

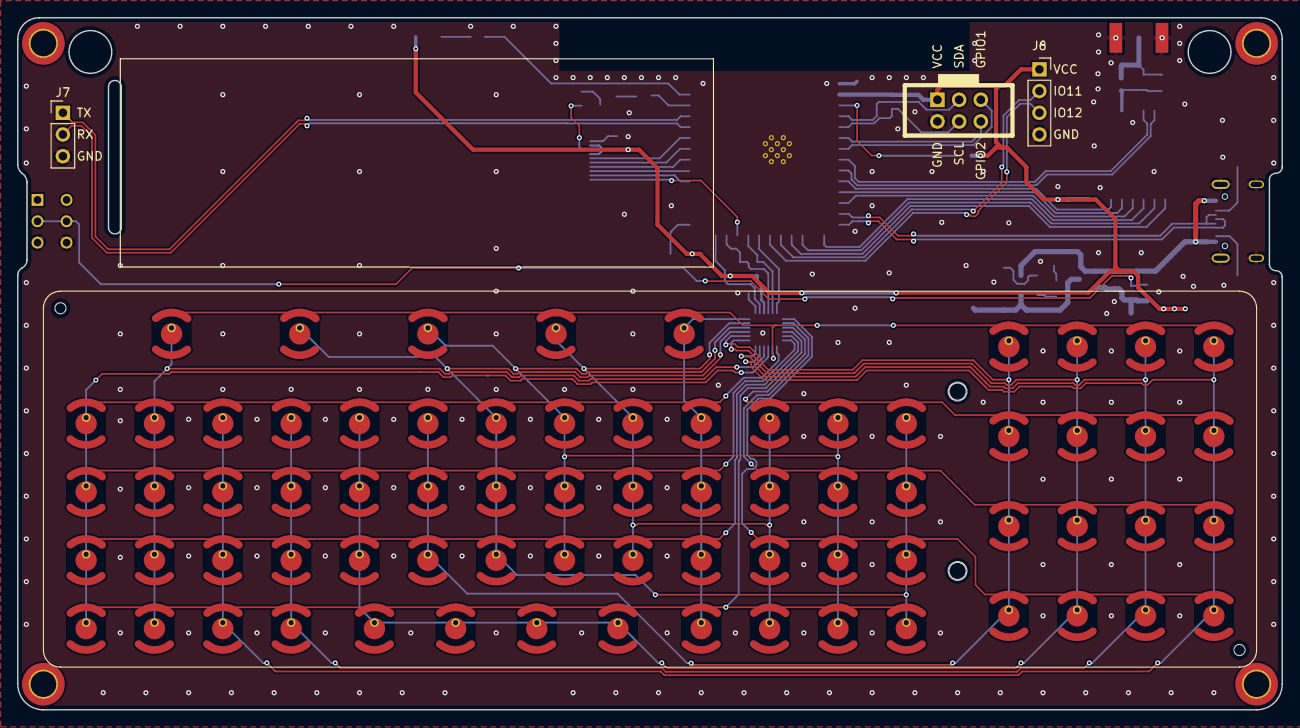
[picture p30: board communicator_pcb.kicad_pcb from above]

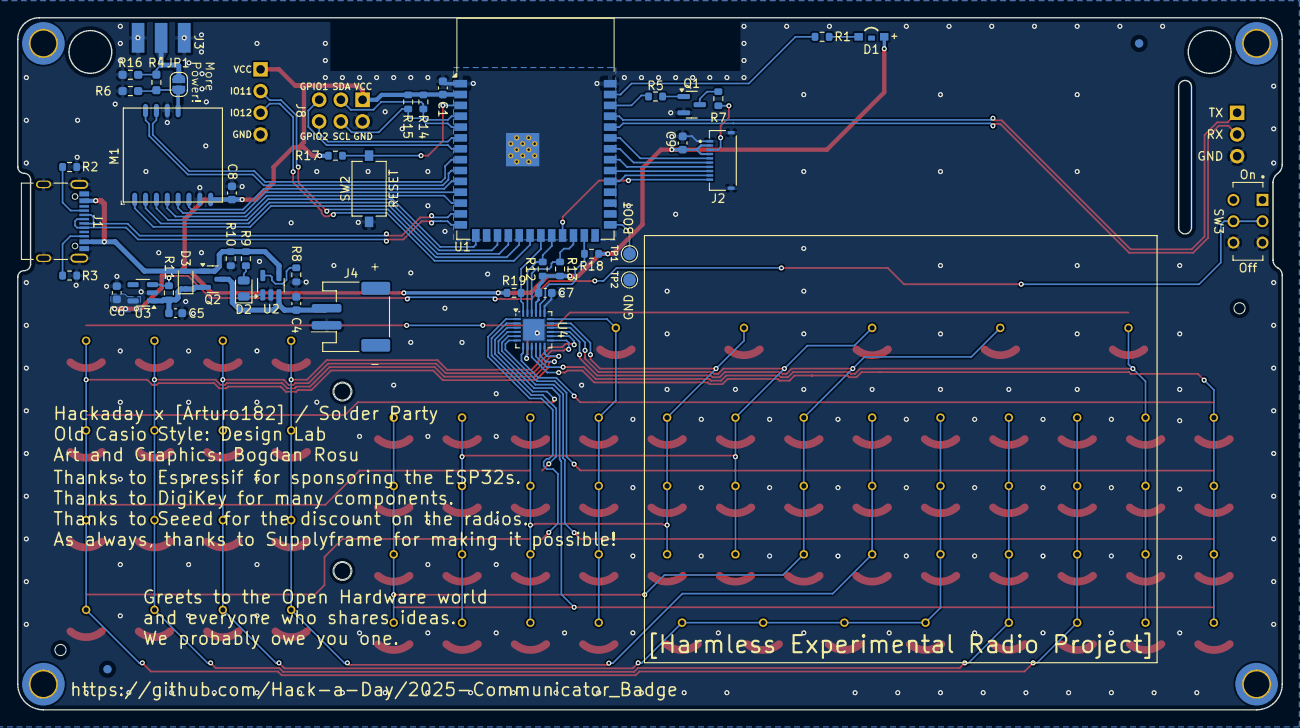
[picture p31: board communicator_pcb.kicad_pcb from below]

Board: 2 copper layers, 148.0 x 81.0 mm, 50 parts (46 on the bottom side), 67 nets.
