kcriqui/2025-Communicator_Badge/(commit log)

2025-10-23 communicator badge front panel
    [communicator_pcb-front_boardBody.dxf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]
2025-10-23 pulling in PCB
    [12402012E212A.step, CON-SMA-EDGE-S.STEP, CON-SMA-EDGE-S.step, Common-Parts-Library.step, Download_STP_WL-SMSW-1204+%28rev1%29.stp, Keyboard.kicad_sch, Power.kicad_sch, QFN50P400X400X80-25N.step]
2025-10-23 fixed outline issues on front pcb
    [front_pcb.kicad_pcb]
2025-10-24 Fixes #3: removing redundant SMA 3D model
    Thanks, [thzinc]!
    [CON-SMA-EDGE-S.STEP]
2025-10-24 importing the badge gasket and back parts
    [Supercon_Badge_2025_Mechanical_Components.stp]
2025-10-24 adding in step, freecad, dxf, and svg conversions
    [communicator_badge_front_pcb.FCStd, communicator_badge_front_pcb.dxf, communicator_badge_front_pcb.step, communicator_badge_main_pcb.FCStd, communicator_mechanical_components.FCStd, communicator_mechanical_components.step]
2025-10-31 Add firmware and associated tooling
    [schedule.csv]
2025-10-31 Fixed mismapped Shift+0 from . to )
    [keyboard.py]
2025-10-31 Replaces the period when shift is active with the right Paren, as on the silkscreen of the keyboard
    [keyboard.py]
2025-10-31 Switch pip install to requirements.txt
2025-10-31 headshot fix.
    [schedule.csv]
2025-10-31 Fix keyboard mapping for `)` (Shift+0)
    [keyboard.py]
2025-10-31 Fix talks entry
    * Fix typo in last name
    * Update image
    [schedule.csv]
2025-10-31 set timestamp on seen messages, fix early expiration bug
    [net.py]
2025-11-01 [i2c][fix] initialize keyboard correctly
    [badge.py, keyboard.py]
2025-11-01 easy Topic switching
    - removes id if alias is specified
    - adds topic seeking (change topic, skipping empty) using left / right arrows
    - updates chat view on topic switch
    - updates chat view on switch_to_foreground
2025-11-01 Handle index error parsing received packets
    [net.py]
2025-11-01 Expanding talks application to track and save interest levels per topic.
2025-11-01 Possibly improve the stability of lvgl by moving its event loop to asyncio
    [lvgl_setup.py]
2025-11-01 Adding AppManager to user apps.
    AppManager is a replacement for the hard-coded User AppMenu app that
    automatically discovers application modules added to the apps directory.
    Simply add some metadata constants to your app module and copy the
    module.py into the apps directory on your device. AppManager will find
    the new module and add the app to its dynamic application menu on reset.
2025-11-02 Remove prints from fish app
